zortness/arduino-dance-pad/img/009.png

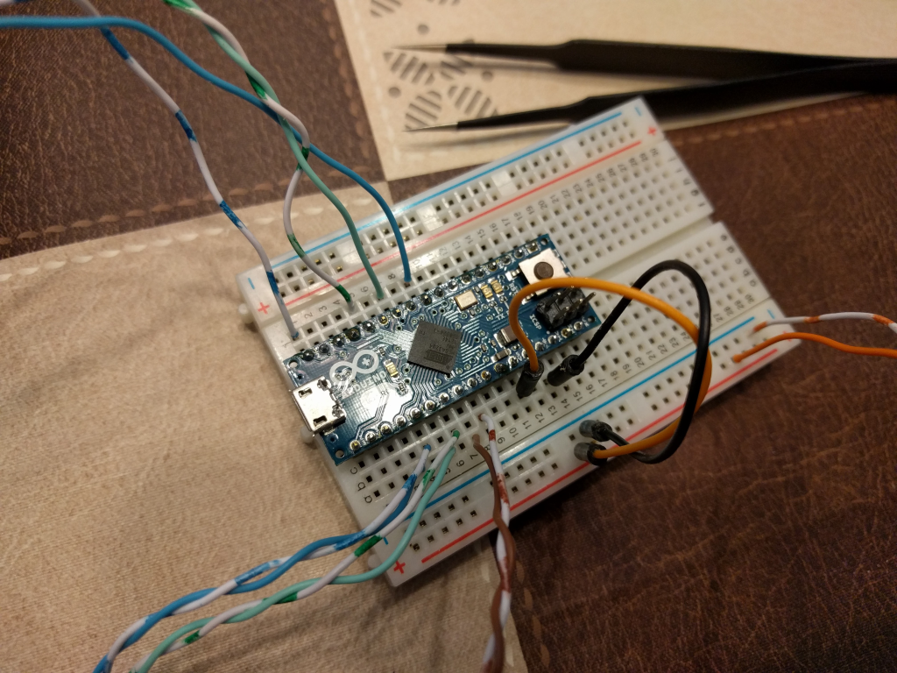
img/009.png
