zortness/arduino-dance-pad/img/013.png

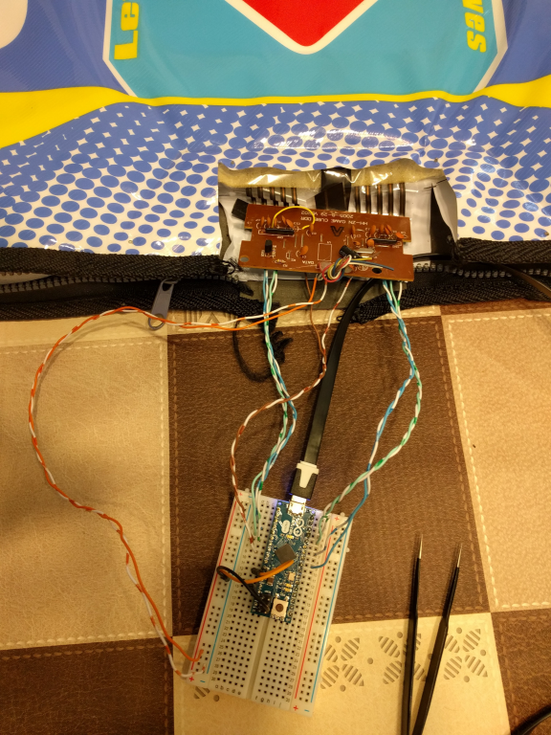
img/013.png
