zortness/arduino-dance-pad/img/001.png

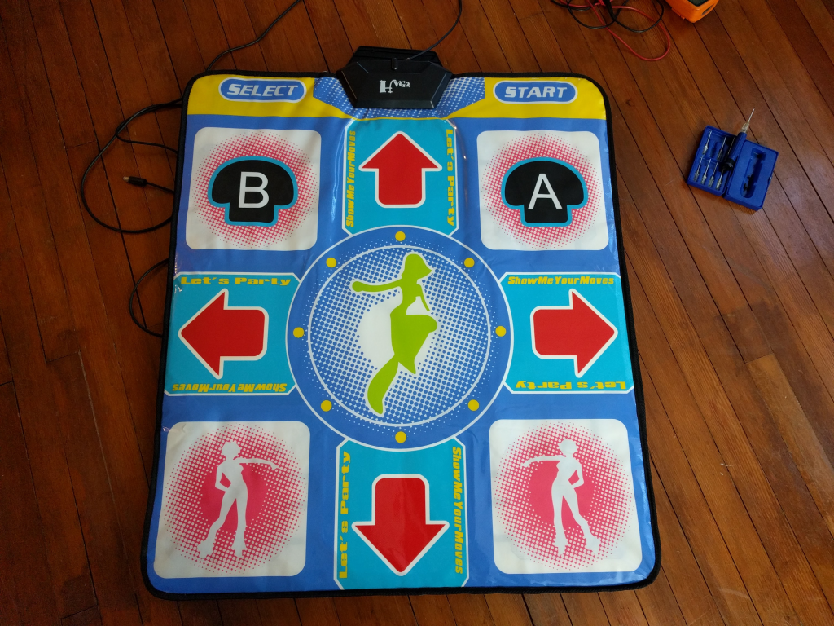
img/001.png
