zortness/arduino-dance-pad/img/002.png

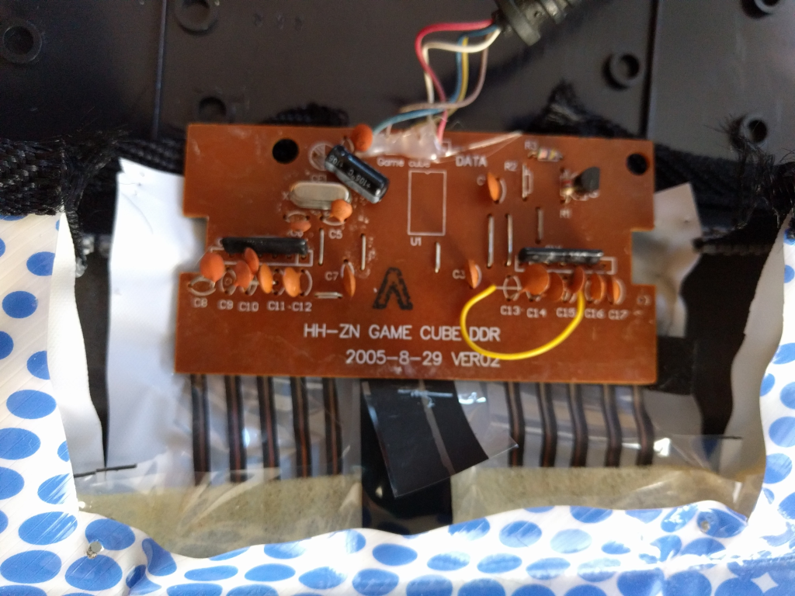
img/002.png
