zortness/arduino-dance-pad/img/003.png

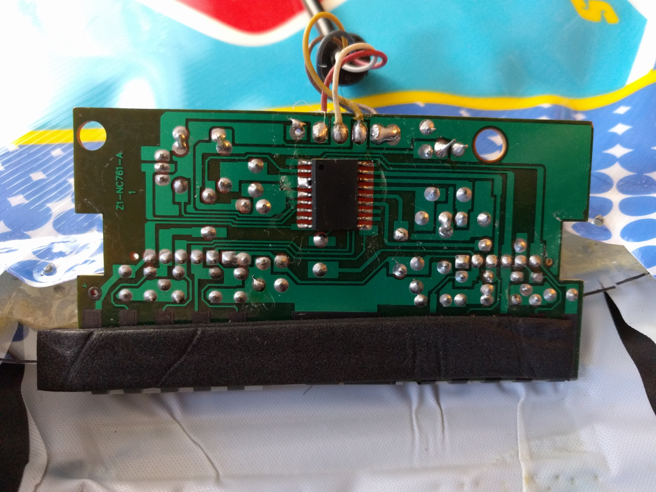
img/003.png
