zortness/arduino-dance-pad/img/004.png

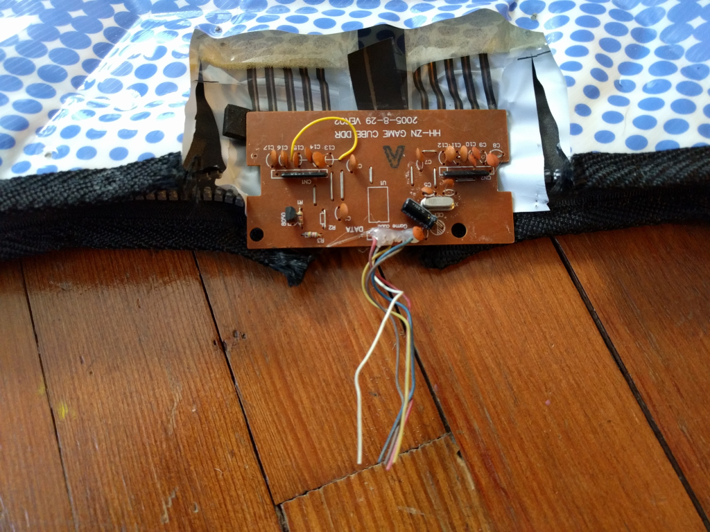
img/004.png
