zortness/arduino-dance-pad/img/005.png

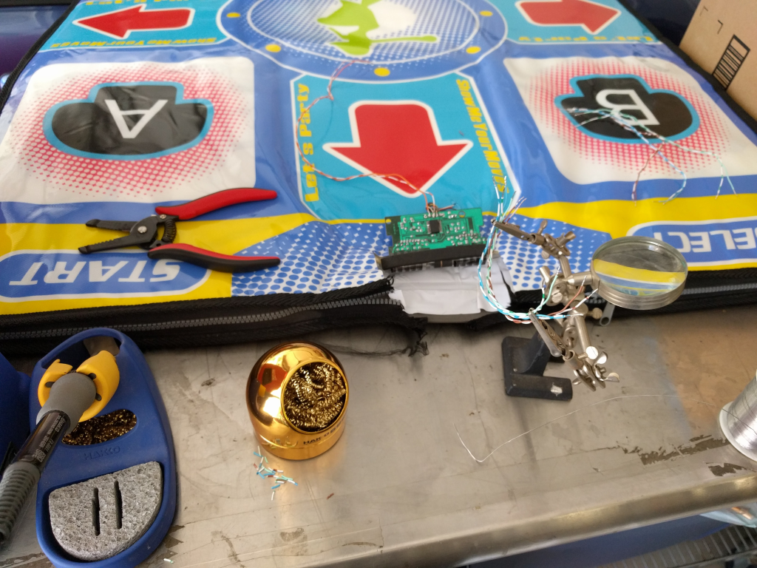
img/005.png
