zortness/arduino-dance-pad/img/006.png

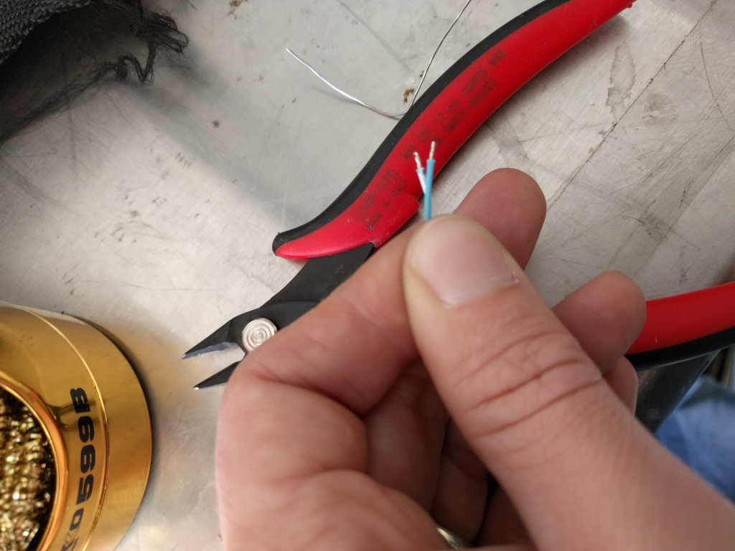
img/006.png
