zortness/arduino-dance-pad/img/007.png

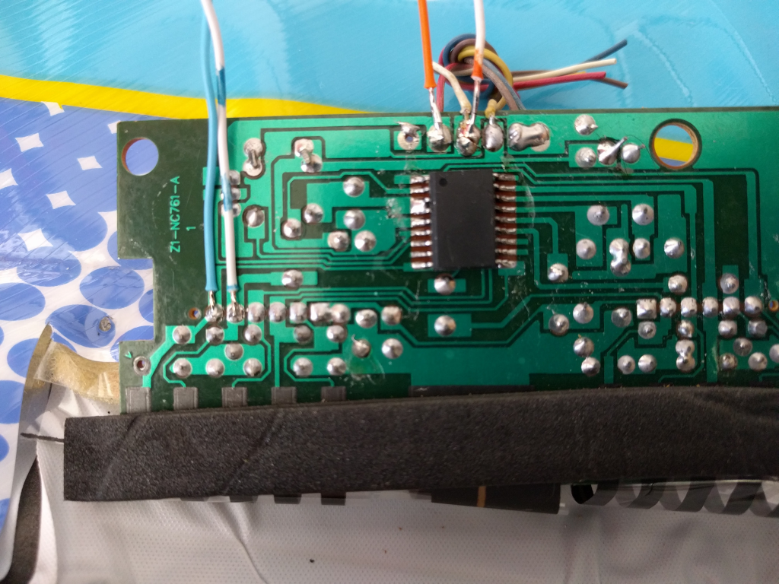
img/007.png
