zortness/arduino-dance-pad/img/008.png

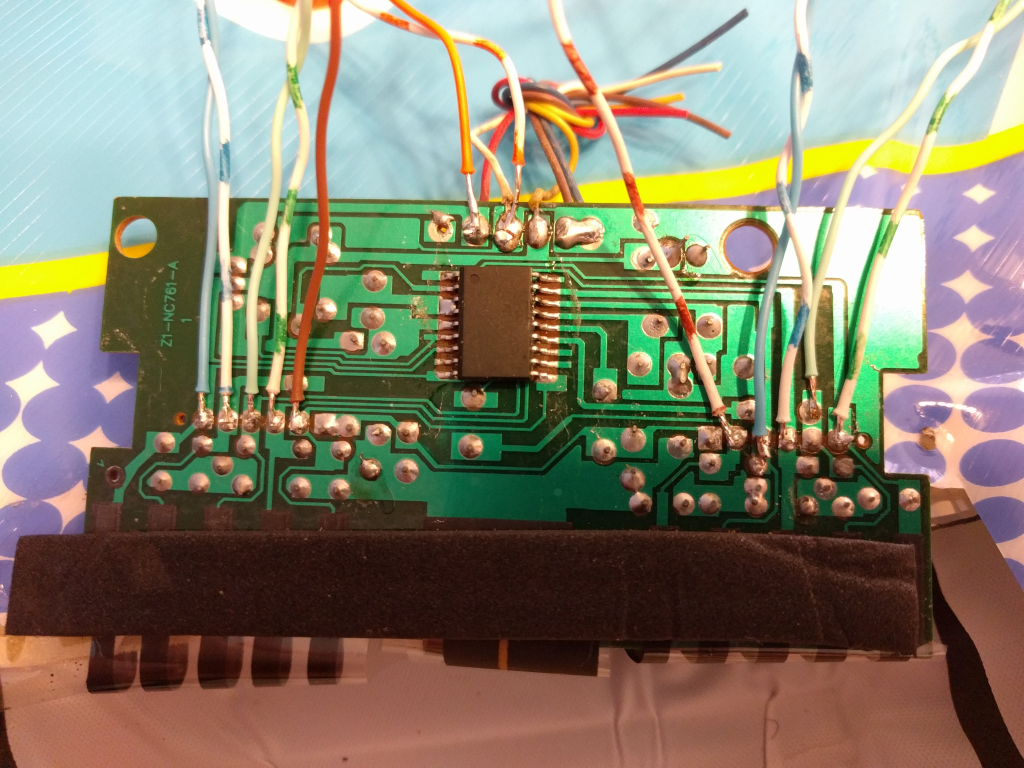
img/008.png
