zortness/arduino-dance-pad/img/010.png

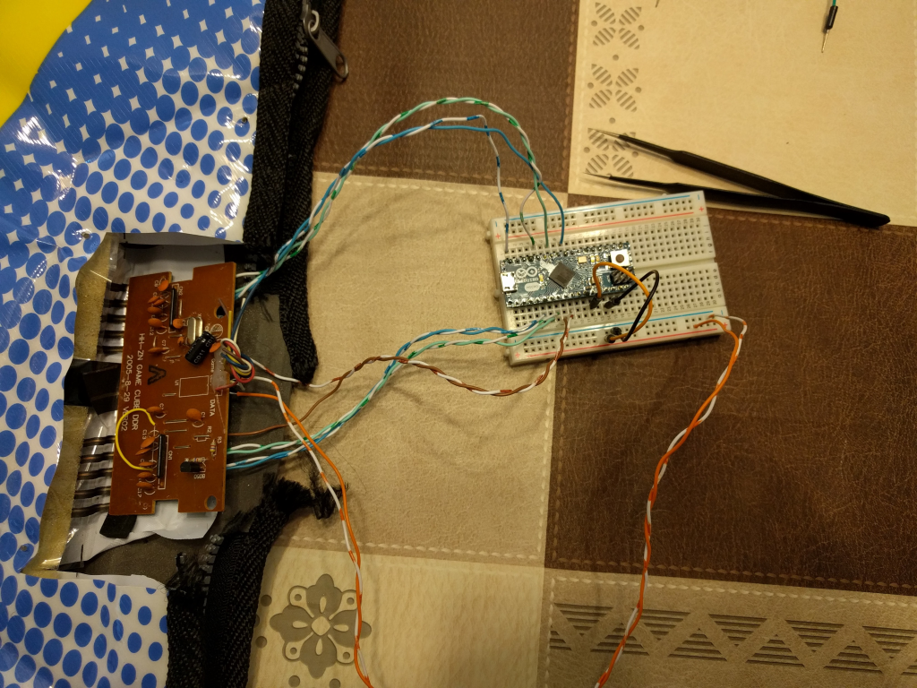
img/010.png
