zortness/arduino-dance-pad/img/011.png

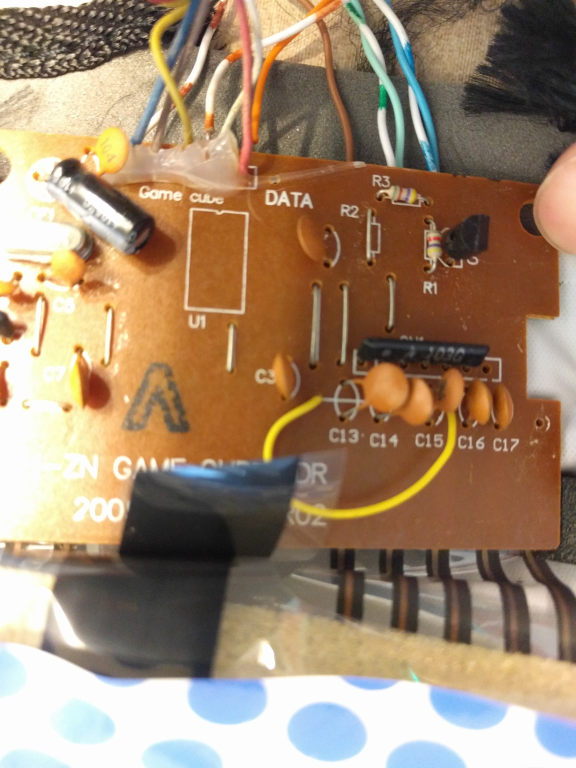
img/011.png
