zortness/arduino-dance-pad/img/012.png

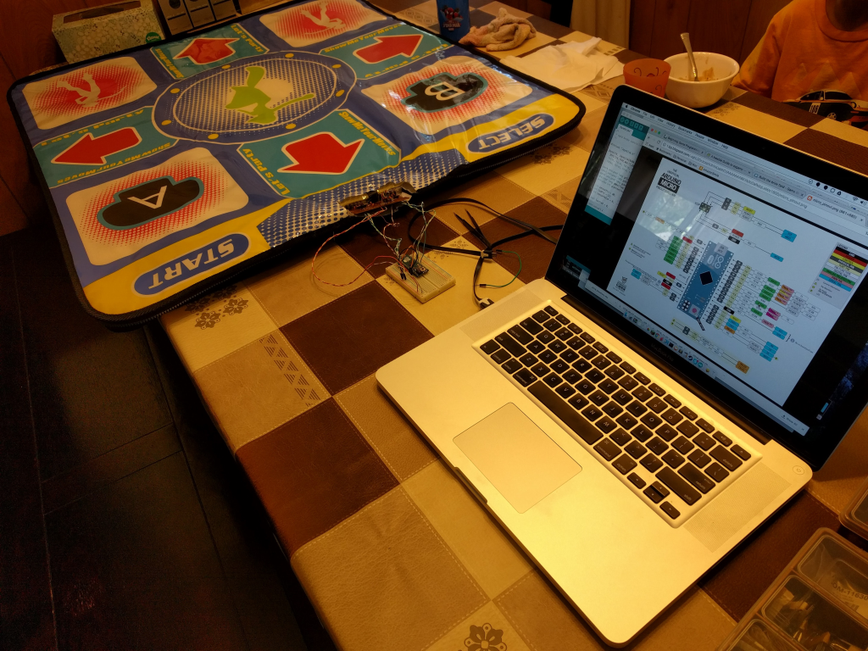
img/012.png
