zortness/arduino-dance-pad/img/014.png

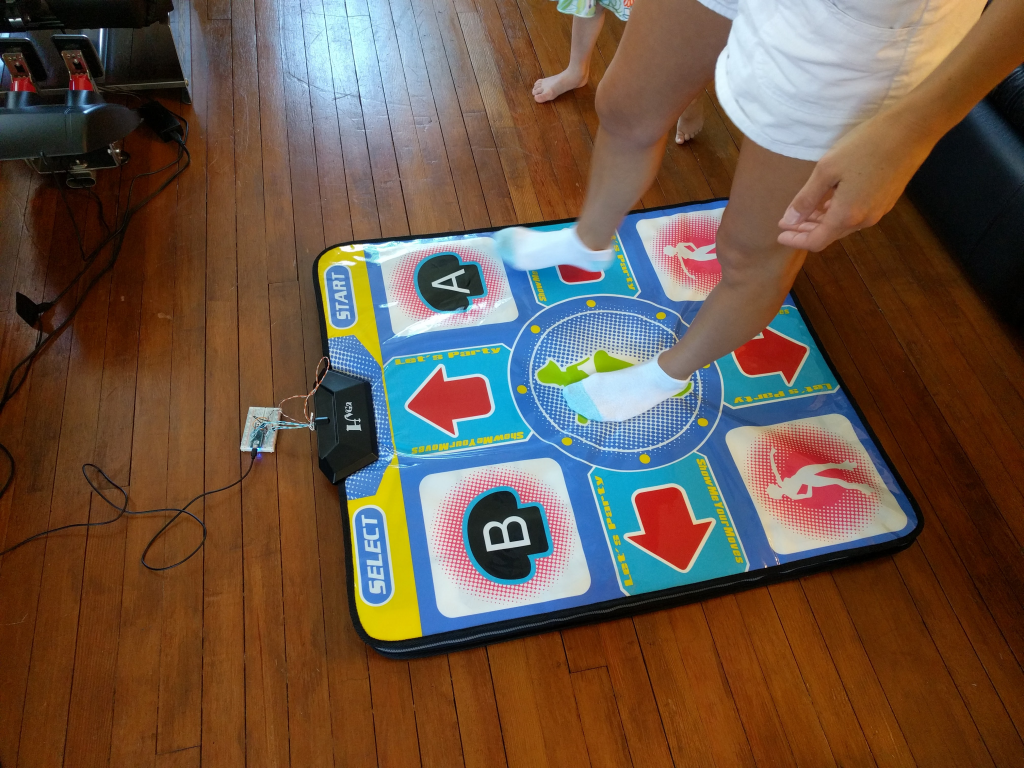
img/014.png
