zortness/arduino-dance-pad/img/015.png

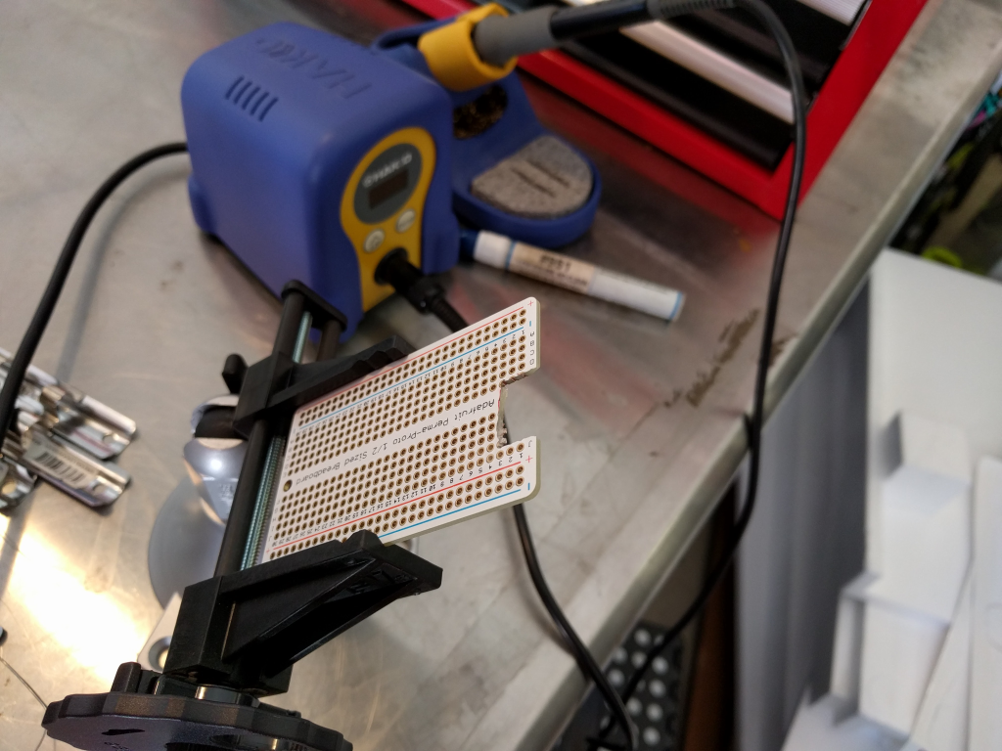
img/015.png
