zortness/arduino-dance-pad/img/016.png

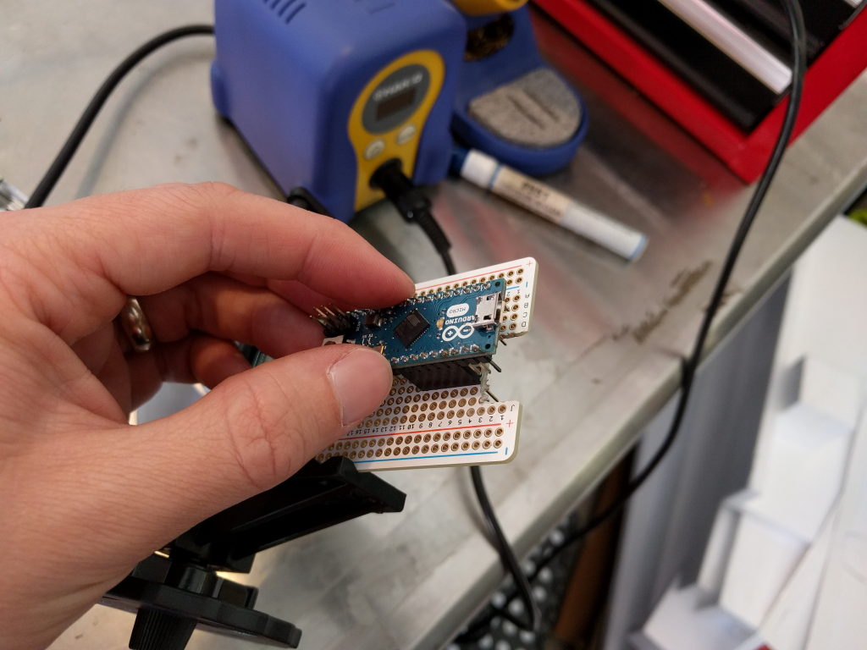
img/016.png
