zortness/arduino-dance-pad/img/017.png

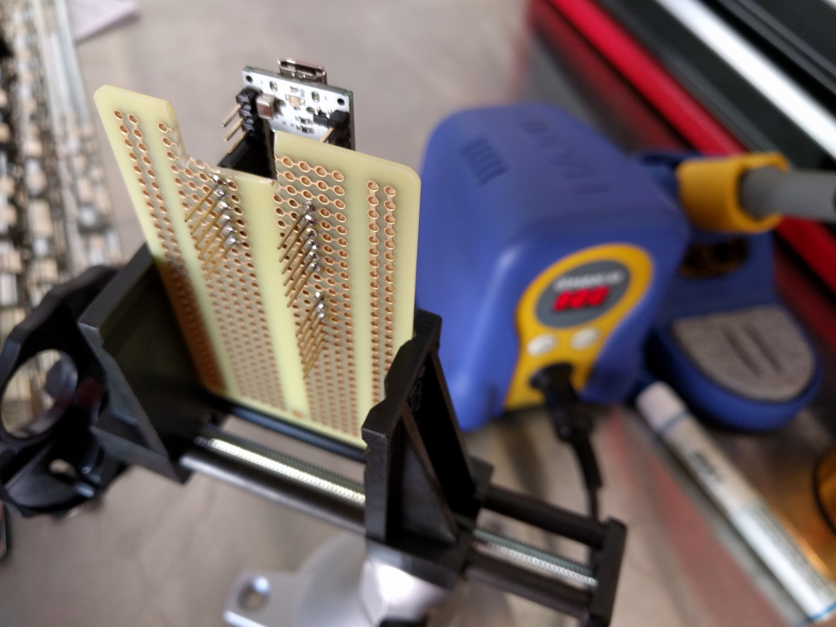
img/017.png
