zortness/arduino-dance-pad/img/018.png

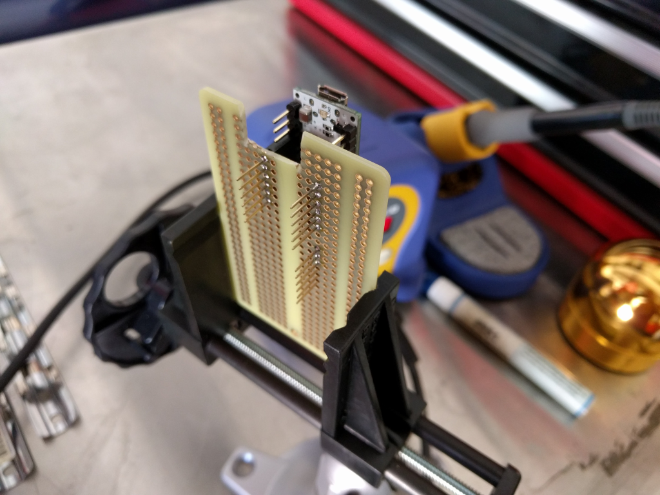
img/018.png
