zortness/arduino-dance-pad/img/019.png

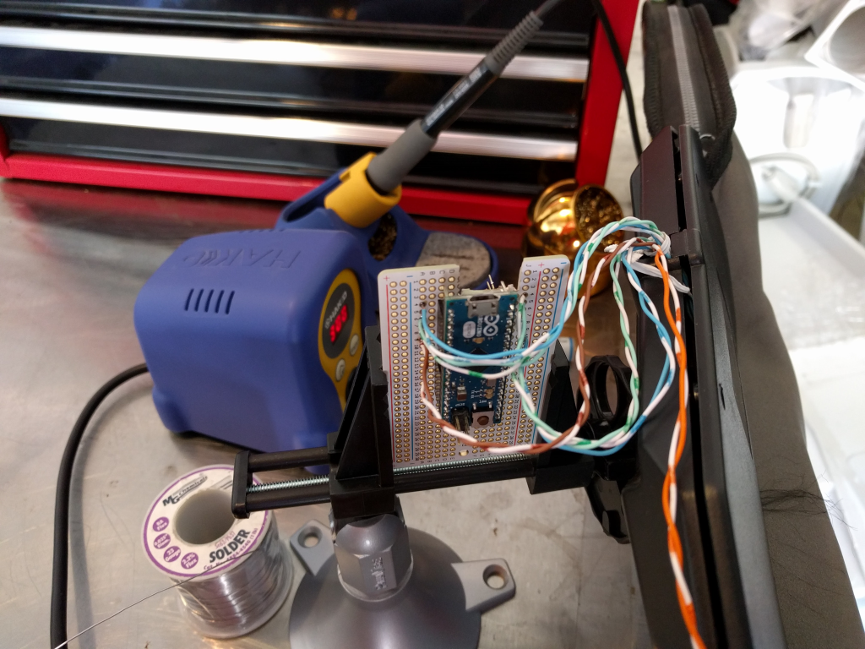
img/019.png
