zortness/arduino-dance-pad/img/020.png

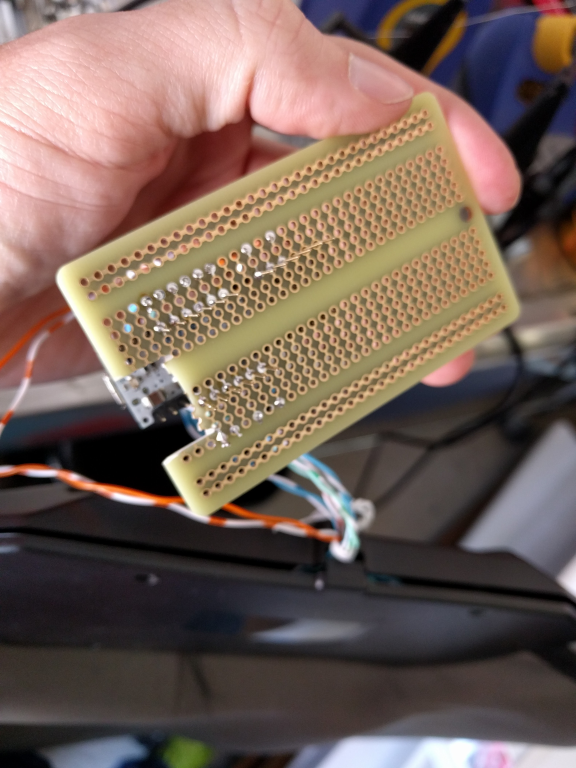
img/020.png
