zortness/arduino-dance-pad/img/021.png

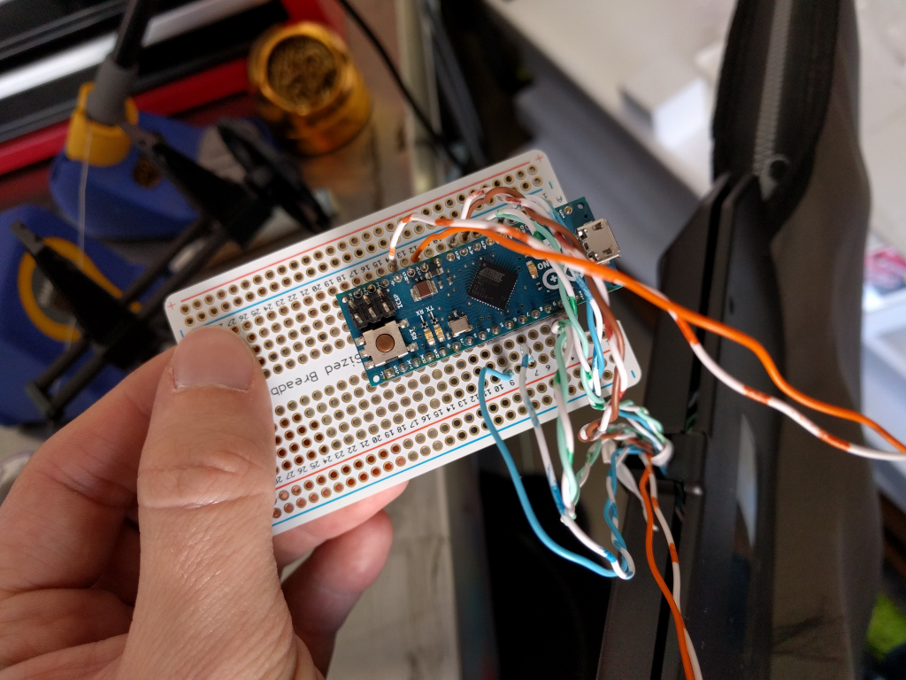
img/021.png
