zortness/arduino-dance-pad/img/022.png

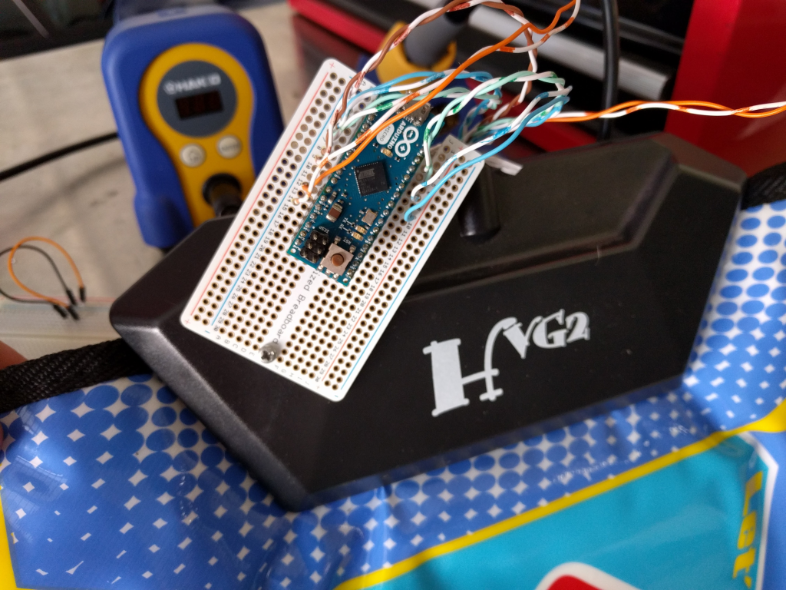
img/022.png
